JonathanDGonzalez/Wind-Turbine-Emulator-Gateway/docs/final_paper.pdf

Emulacion experimental y supervisi ´ | on SCADA de ´

# un subsistema eolico de 300 W para microrredes DC ´ basado en PMSG

Jonathan David Gonzalez Cubides ´
Departamento de Ingeniería Electrica y Electr ´ | onica ´
Universidad de los Andes
Bogota, Colombia ´
jd.gonzalezc1@uniandes.edu.co 202210906

Juan David Roa Ballen´
Departamento de Ingeniería Electrica y Electr ´ | onica ´
Universidad de los Andes
Bogota, Colombia ´
jd.roab1@uniandes.edu.co
202212846

Cristian David Gonzalez Mayorga ´
Departamento de Ingeniería Electrica y Electr ´ | onica ´
Universidad de los Andes
Bogota, Colombia ´
cd.gonzalezm1@uniandes.edu.co 202210911
Resumen—Este documento presenta el diseno, implementaci ˜ | on´
y validacion experimental de un subsistema e ´ | olico de baja ´
potencia (300 W) orientado a su integracion en una microrred ´ DC de laboratorio de 48 V. El subsistema propuesto consta de un generador síncrono de imanes permanentes (PMSG)
acoplado mecanicamente a un motor de inducci ´ | on operado por ´
un variador de frecuencia comercial. El control del variador se realiza mediante una pasarela de comunicacion basada en un ´
sistema embebido que actua de forma simult ´ | anea como maestro ´
Modbus RTU y servidor Modbus TCP, permitiendo la emulacion´ automatizada de perfiles reales de velocidad de viento sintetizados
a partir de datos meteorologicos y la supervisi ´ | on en tiempo real ´
desde un sistema SCADA externo. La validacion experimental ´
confirmo con precisi ´ | on las relaciones f ´ | ísicas fundamentales de
la maquina, demostrando un comportamiento lineal tensi ´ | on- ´
frecuencia (V ∝ ω) y cuadratico potencia-frecuencia ( ´ | P ∝ ω

2
),
con margenes de error inferiores al 5 % en todo el rango de ´ operacion. Con esto, se valida la robustez y viabilidad de la ´ plataforma como herramienta de prueba para estrategias de
control y gestion en microgeneraci ´ | on distribuida. ´
Palabras clave—control de microgeneracion, emulaci ´ | on e ´ | olica, ´
microrredes DC, PMSG, Protocolos de comunicacion industrial, ´ sistemas embebidos de bajo costo.
I. INTRODUCCION´

El creciente interes en las microrredes de corriente continua ´
(DC) como arquitectura eficiente para la integracion de energ ´ | ías
renovables, sistemas de almacenamiento y cargas electronicas ´ ha motivado el desarrollo de prototipos de laboratorio que
permitan estudiar fenomenos de estabilidad, control y gesti ´ | on´
energetica [1]. Dentro de las fuentes renovables, la generaci ´ | on´
eolica presenta desaf ´ | íos particulares debido a la variabilidad
temporal del recurso y a su naturaleza de corriente alterna (AC), que exige etapas de rectificacion, acondicionamiento y ´ control para su acoplamiento a un bus DC comun. ´
En sistemas de baja potencia (300 W–1 kW), los generadores síncronos de imanes permanentes (PMSG) se han posicionado como una opcion atractiva por su alta eficiencia, mantenimiento ´ reducido y facilidad de control [2], [3]. Sin embargo, gran parte de los estudios reportados en la literatura se basan en simulaciones computacionales o emplean plataformas de control cerradas y costosas, limitando la reproducibilidad y el
acceso en entornos academicos de desarrollo local. Adem ´ | as, ´

existe una brecha en la integracion de sistemas de sensado ´ accesibles con estrategias de emulacion de perfiles de viento ´ realistas bajo entornos de supervision industrial estandarizados. ´ Factor diferenciador de este trabajo: integracion completa ´ de una metodología de emulacion reproducible fundamentada ´
en perfiles sinteticos din ´ | amicos obtenidos a partir del ´ | Global
Wind Atlas. El control del sistema se implementa mediante un entorno accesible compuesto por una Raspberry Pi 4 que opera sobre un variador comercial Allen-Bradley PowerFlex
525 vía Modbus RTU, acoplandose directamente a la validaci ´ | on´
experimental del generador PMSG AVAN-300W mediante software de codigo abierto en Python. A diferencia de las ´ aproximaciones convencionales que dependen de simulacion´ computacional pura o de costosas plataformas dSPACE que restringen su escalabilidad, este esquema proporciona un banco de ensayos flexible y de bajo costo. La plataforma permite caracterizar parametricamente el PMSG mediante curvas de ´
tension-corriente ( ´ | V -I) y eficiencia, validar algoritmos de
seguimiento del punto de maxima potencia (MPPT), evaluar ´ el comportamiento de convertidores AC-DC bajo perfiles transitorios y dimensionar microrredes DC experimentales para aplicaciones aisladas.
Por lo tanto, la principal contribucion de este trabajo radica ´ en el desarrollo de una plataforma de emulacion e ´ olica que no ´ solo reproduce perfiles dinamicos reales basados en bases de ´
datos meteorologicas globales, sino que integra la telemetr ´ | ía
local de una PCB propia con la supervision jer ´ | arquica industrial. ´
Esto permite estudiar el impacto de la microgeneracion y los ´ armonicos de corriente en microrredes DC bajo condiciones ´ controladas y repetibles de laboratorio.
El resto de este documento esta organizado de la siguiente ´
manera: la Seccion II describe los fundamentos te ´ | oricos, la ´
síntesis de perfiles de viento y el marco regulatorio. La Seccion´
III detalla el sistema de instrumentacion y supervisi ´ | on SCADA. ´
La Seccion IV presenta el an ´ | alisis comparativo de m ´ | aquinas ´
electricas. La Secci ´ | on V expone los paradigmas de control ´
MPPT y la proyeccion de desarrollo tecnol ´ | ogico. La Secci ´ | on´
VI analiza los resultados de la validacion experimental y la ´
caracterizacion electromec ´ | anica. La Secci ´ | on VII aborda la es- ´
trategia de conversion frecuencial y s ´ | íntesis del perfil dinamico ´

de viento. La Seccion VIII profundiza en la arquitectura de ´ comunicacion concurrente y la pasarela dual Modbus, y la ´
Seccion IX resume las conclusiones de la investigaci ´ | on. ´
II. FUNDAMENTOS TEORICOS ´ | , SÍNTESIS DE VIENTO Y

CONTEXTO NORMATIVO

La emulacion precisa de una turbina e ´ | olica en un entorno ´
de laboratorio requiere la integracion de bases de datos ´
meteorologicas de alta resoluci ´ | on, el modelamiento de la ´
extraccion de potencia mec ´ | anica del rotor y el an ´ | alisis de ´
la etapa de conversion est ´ | atica bajo el marco regulatorio ´
internacional.

II-A. Fuentes de Datos y Seleccion del Recurso ´
La caracterizacion matem ´ | atica del recurso e ´ | olico depende ´
de matrices validadas. Arquitecturas globales como NASA POWER [4] y el NREL WIND Toolkit [5] proporcionan series temporales extensas mediante modelos de mesoescala WRF. No obstante, para el desarrollo de plataformas de emulacion a ´ microescala, el Global Wind Atlas (GWA) desarrollado por la
DTU [6] constituye el estandar ´ | optimo debido a su resoluci ´ | on´
espacial de 250 m y al modelamiento microtopografico del ´ flujo. Para este estudio, se seleccionaron los datos climaticos ´ de la region de La Guajira, Colombia. A partir del GWA se ´ extrajeron dos conjuntos de datos: la matriz de distribucion´ horaria y mensual de velocidad media (heatmapData.csv) y la densidad de probabilidad de percentiles de velocidad (windSpeed.csv), permitiendo sintetizar perfiles dinamicos ´ representativos que superan las aproximaciones convencionales.

II-B. Modelamiento Aerodinamico de la Turbina ´
Un emulador eolico reproduce la respuesta din ´ | amica de un ´
rotor real acoplando mecanicamente un motor de accionamiento ´ controlado a un generador electrico [7], [8]. Para una turbina ´
eolica de eje horizontal (HAWT), el par aerodin ´ | amico ( ´ | Tturb)
transferido al eje se deriva de la potencia cinetica extra ´ | ída del
flujo de viento:

Tturb =

1
2

ρACp(λ, β)

v

3
w
ω

(1)

donde ρ representa la densidad local del aire, A es el area de ´
la seccion transversal barrida por las palas, ´ | | vw es la velocidad
instantanea del viento y ´ | ω es la velocidad angular mecanica del ´
rotor. El coeficiente de potencia Cp es una funcion no lineal ´
adimensional que depende del angulo de paso de la pala ( ´ | | β)
y de la relacion de velocidad perif ´ | erica ( ´ | λ = ωR/vw), donde
R corresponde al radio exterior del rotor. En configuraciones de eje vertical (VAWT) tipo Savonius, el par aerodinamico se ´ modela mediante el coeficiente de par efectivo (CT ), reduciendo
la sensibilidad cubica de la velocidad del viento a una relaci ´ | | on´
cuadratica dada por: ´

Tturb,VAWT =

1
2

ρAlatRefCT (λ)v

2
w | (2)
donde Alat es el area lateral proyectada y ´ | Ref es el radio
geometrico efectivo del dispositivo. Las variaciones din ´ | amicas ´

de vw se traducen en consignas de frecuencia electrica aplicadas ´ al estator del motor de induccion para simular la inercia ´ mecanica y las curvas de par reales. ´

II-C. Síntesis Estocastica de Perfiles de Viento para Ensayo ´ Para evaluar la robustez de la microrred DC ante transitorios, un algoritmo de síntesis estocastica en Python genera perfiles de ´ viento de tres días con resolucion de ´ ∆t = 1.0 s, combinando componentes determinado-estacionales y fluctuaciones de alta frecuencia:

vw(t) = α · vbase(h, m) + r · vturb(t) | (3)

donde vbase es la velocidad media diurna y mensual del
GWA segun la hora ( ´ | h) y el mes (m), ponderado por un
coeficiente espectral α = 0.7. La turbulencia se introduce
mediante el termino ´ | vturb(t), generado a traves de un muestreo ´
aleatorio sobre la probabilidad empírica de la region ( ´ | r = 0.3).
Para eliminar discontinuidades no físicas y emular la inercia atmosferica real, la serie temporal se somete a un filtro de ´ media movil s ´ íncrono:

vfinal(t) = 1
N

N/
X

2

i=−N/2

vw(t + i∆t) | (4)

con una ventana de suavizado de N = 10 muestras. Este perfil se convierte a consignas limitadas por las velocidades de corte (cut-in de 3.0 m/s, cut-out de 25.0 m/s) y nominal
(11.0 m/s), exportandose a ´ | | perfil_viento.csv como la
entrada dinamica para la pasarela de control. ´
II-D. Topologías de Rectificacion e Integraci ´ | on Normativa ´
La conversion de la energ ´ | ía AC generada por el PMSG hacia
el bus DC se efectua primariamente mediante un puente de ´ diodos trifasico no controlado de seis pulsos (puente de Graetz). ´ Esta topología destaca por su alta confiabilidad, ausencia de
perdidas por conmutaci ´ | on activa y costo m ´ | ínimo [9]. El voltaje
DC promedio obtenido en bornes bajo condiciones de vacío responde a VDC,avg = (3√
| | 2/π)Vrms,linea. A pesar de sus
ventajas estructurales, esta configuracion pasiva exhibe un ´ rizado del 16 % y carece de regulacion activa, provocando ´
caídas de tension severas gobernadas por la reactancia s ´ | | íncrona
interna del PMSG ante la conexion de cargas. Como alternativa ´ avanzada para independizar el voltaje del bus de la carga y controlar el factor de potencia, se consideran las arquitecturas controladas por modulacion de ancho de pulso (PWM) basadas ´ en IGBTs. Convertidores tipo elevador, como el rectificador
SEPIC trifasico operado en modo de conducci ´ | | on discontinua ´
(DCM), aprovechan las inductancias internas del estator como filtros de entrada, reduciendo la distorsion arm ´ onica al forzar ´ corrientes senoidales en fase con los voltajes inducidos y proveyendo una regulacion del bus con errores inferiores al ´ 3 % sin requerir lazos de comunicacion externa [10], [11]. ´ Esta integracion est ´ a sujeta a normativas internacionales ´ orientadas a preservar la calidad de la energía. El estandar ´ IEC 61400-21 restringe el parpadeo lumínico (flicker de corto plazo, Pst) a un valor maximo de 0.3 para 10 eventos en un ´

intervalo de 2 horas, limitando la distorsion arm ´ onica total ´ (THD) por debajo del 5 %, y exigiendo un desequilibrio de
tension inferior al 2 % en per ´ | íodos de 10 minutos [12]. Por
su parte, la norma IEEE 1547-2018 regula la interconexion de ´ recursos distribuidos, imponiendo rangos operativos de tension´ entre el 88 % y el 110 % del valor nominal, tolerancias de frecuencia de 59.3 Hz a 60.5 Hz, y capacidad de soporte ante fallas (Fault Ride-Through, FRT) [13]. Debido a que el subsistema desarrollado opera en una microrred de laboratorio en modo aislado (islanding), los requerimientos de soporte ante fallas masivas (FRT) y los lazos de sincronizacion de ´ fase (PLL) pasan a un plano secundario. Los esfuerzos se reorientan hacia la gestion local del balance de potencia activa, ´ la mitigacion de sobretensiones transitorias en el bus de 48 V ´ mediante la pasarela embebida, y la instrumentacion de alta ´ fidelidad para caracterizar la respuesta electromecanica del ´ banco de ensayos.

III. SISTEMA DE INSTRUMENTACION´ , ADQUISICION Y ´ SUPERVISION´ SCADA

La caracterizacion din ´ | amica del subsistema e ´ | olico y la ´
evaluacion de su impacto en la estabilidad de la microrred ´ DC requieren una arquitectura de instrumentacion de alta ´
fidelidad, capaz de registrar variables electricas y t ´ | ermicas ´
de forma simultanea sin introducir retardos en los lazos de ´ control locales.
III-A. Instrumentacion Electr ´ | onica y Adquisici ´ | on en la Fron- ´
tera (Edge)
Para la digitalizacion y procesamiento de las se ´ | nales anal ˜ | ogi- ´
cas en el nodo primario de control, se desarrollo un sistema ´ de adquisicion basado en el microcontrolador de arquitectura ´ abierta ESP32-S2 WROVER. Este dispositivo gestiona el acondicionamiento de senales provenientes de transductores ˜ específicos seleccionados por su linealidad y rango dinamico, ´ los cuales se consolidan en la Tabla I.

Tabla I: Sensores Integrados en la Plataforma Experimental

Variable Mapeada | Transductor Integrado | Interfaz de Datos
Corriente AC/DC | ACS758LCB-050B (Efecto Hall) | Analogica (ADC) ´
Tension y Potencia DC | M ´ | odulo INA226 (Monitoreo Bus) | Digital (I ´

2C)
Temperatura de Maquina Termocupla Tipo K + MAX6675 | Digital (SPI) ´
Procesamiento de Borde | ESP32-S2 WROVER Core | MCU 32-bits

La topología de hardware aprovecha el convertidor analogico- ´ digital (ADC) nativo de 12 bits del microcontrolador para el seguimiento de la corriente inyectada por el rectificador, implementando filtros digitales de media movil para mitigar ´ el ruido de alta frecuencia inducido por las conmutaciones. Asimismo, la integracion del monitor de potencia INA226 ´ mediante el bus I

2C permite independizar la lectura de la
tension del bus de 48 V con una resoluci ´ | | on centesimal superior, ´
asegurando un error de cuantificacion despreciable en el c ´ | alculo ´
del balance energetico neto. ´

III-B. Arquitectura IoT de Supervision y Monitoreo Remoto ´

Para lograr un flujo de informacion bidireccional continuo ´ hacia el entorno de supervision jer ´ arquica sin degradar los ´ tiempos de ciclo del maestro Modbus RTU, se implementó una arquitectura distribuida orientada al Internet de las Cosas Industrial (IIoT), estructurada de acuerdo con la topología jerarquica de la Figura 1. ´

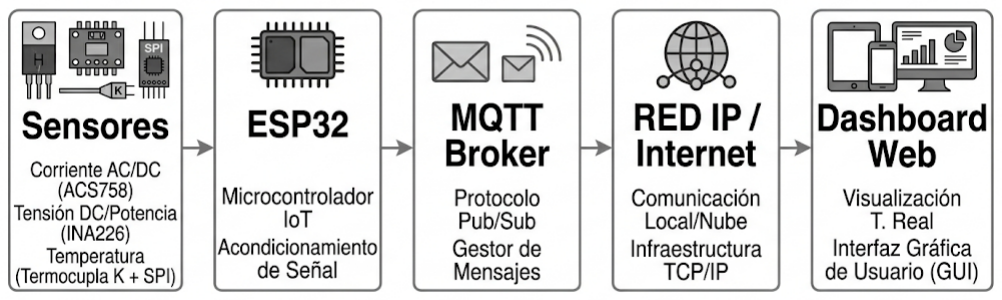
[picture p1: figure]

Figura 1: Arquitectura IoT de supervision distribuida y capas ´ de telemetría.

El esquema operativo se divide en tres capas funcionales continuas: la Capa de Borde (Edge Computing), donde el firmware del ESP32 realiza el muestreo determinista de las variables físicas y empaqueta las lecturas en una estructura de datos serializada; la Capa de Transporte Asíncrono, encar-gada de la transmision inal ´ ambrica hacia un servidor central ´ (Broker) bajo el protocolo MQTT, seleccionado por su modelo
Publicacion/Suscripci ´ | on (Pub/Sub) y m ´ | ínima sobrecarga de red
(overhead) frente a esquemas HTTP; y la Capa de Aplicacion y ´
Visualizacion´ , donde los topicos de telemetr ´ | ía son consumidos
en tiempo real por un Dashboard supervisor para ejecutar
tareas de registro historico ( ´ | datalogging) indispensable en la
validacion emp ´ | írica de las curvas de eficiencia.
IV. ANALISIS ´ | COMPARATIVO DE MAQUINAS ´ | ELECTRICAS ´
PARA MICRO-EOLICA ´
La seleccion del generador el ´ | | | ectrico representa el criterio de ´
diseno cr ˜ | ítico en sistemas eolicos a peque ´ | na escala (300 W a ˜
1 kW), puesto que determina la configuracion de las etapas de ´ potencia y los límites operativos del control de velocidad. En este rango, coexisten tres topologías principales: las maquinas ´
de induccion, las m ´ | aquinas s ´ | íncronas excitadas por campo y
los generadores síncronos de imanes permanentes (PMSG) [2], [3].
Tabla II: Matriz de Seleccion Tecnol ´ | ogica de Generadores ´
Eolicos ´
Metrica de Evaluaci ´ | on | Inducci ´ | on | S ´ | íncrono Exc. | PMSG
Naturaleza de la Salida | AC Variable | AC Variable | AC Variable
Mecanismo de Excitacion Externa (Red) Corriente Campo Imanes Internos ´
Rango Operativo de ω | Reducido | Moderado | Amplio
Eficiencia Energetica | Media | Media-Alta | Sobresaliente ´
Complejidad de Control | Moderada | Elevada | Reducida
Frecuencia Mantenimiento | Mínima | Moderada-Alta | Mínima
Acoplamiento a Bus DC | Moderado | Complejo | Optimo ´
Costo Estructural Relativo | Bajo | Medio | Medio-Alto

Como se tabula en la matriz de seleccion de la Tabla II, las ´
maquinas de inducci ´ | on exhiben restricciones severas debido a ´
su necesidad de una fuente externa de potencia reactiva para establecer el flujo magnetico, limitando su operabilidad en ´ microrredes aisladas. Por otro lado, los generadores síncronos excitados por bobinados de campo introducen perdidas ´ ohmicas ´ adicionales en el rotor y requieren anillos rozantes que elevan los índices de mantenimiento.
Por consiguiente, para el desarrollo de este emulador se selecciono un generador tipo PMSG (AVAN-300W). Esta ´
maquina elimina por completo los lazos de excitaci ´ | | on activa ´
mediante la incorporacion de imanes permanentes de alta ´ densidad energetica, maximizando la eficiencia global de ´ conversion y garantizando un acoplamiento directo y altamente ´ lineal con el bus de rectificacion pasiva DC bajo un rango ´
extendido de velocidades mecanicas de rotaci ´ | on. ´
V. ESTRATEGIAS DE CONTROL MPPT Y PROYECCION DE ´
| DESARROLLO FUTURO
La integracion eficiente del subsistema e ´ | olico basado en ´
PMSG dentro de una microrred DC requiere de algoritmos de
seguimiento del punto de maxima potencia ( ´ | Maximum Power
Point Tracking, MPPT) adaptados a la dinamica transitoria ´
del recurso eolico sint ´ | etico. El objetivo fundamental de estas ´
estrategias consiste en manipular la velocidad angular del rotor (ω) para mantener el sistema operando de manera continua en
la razon de velocidad de punta ´ | optima ( ´ | λopt), maximizando
así el coeficiente de rendimiento aerodinamico ( ´ | Cp).

V-A. Paradigmas de Control MPPT en Maquinas PMSG ´
En el diseno de emuladores y sistemas micro-e ˜ | olicos ´
reales, coexisten tres filosofías principales de optimizacion. ´
El control por relacion de velocidad de punta ( ´ | Tip Speed
Ratio, TSR) calcula en tiempo real la velocidad angular optima ´
mediante la medicion directa del viento utilizando la relaci ´ | | | on´
ωref = (λopt/R)vw. Aunque exhibe una respuesta transitoria
veloz, depende críticamente de un anemometro f ´ | ísico, el
cual introduce costos adicionales y errores por turbulencias
locales. Para prescindir de estos sensores mecanicos, el m ´ | etodo ´
de control de par optimo ( ´ | Optimal Torque Control, OTC)
explota la relacion cuadr ´ | atica intr ´ | ínseca de la turbina mediante
la ley Topt | = kω²
, donde k se calibra a partir de los
parametros geom ´ | etricos del rotor y la densidad del aire. ´
El metodo OTC destaca por su robustez frente a r ´ | afagas ´
de viento y su simplicidad computacional, permitiendo su codificacion directa en el ESP32 sin comprometer los tiempos ´ de ciclo. Finalmente, cuando las constantes constructivas son
desconocidas o varían por degradacion mec ´ | anica, se recurre a ´
la busqueda adaptativa por perturbaci ´ | on y observaci ´ | on ( ´ | Hill
Climbing Search, HCS). Este algoritmo, agnostico al modelo ´ físico, perturba cíclicamente la velocidad de referencia y evaluá el gradiente de potencia neta (∆P/∆ω) para converger al
optimo; no obstante, su velocidad de convergencia es m ´ | | | as´
lenta y exhibe oscilaciones en regimen permanente. La elevada ´ linealidad de la fuerza electromotriz (FEM) inducida respecto a la velocidad angular del PMSG seleccionado facilita la futura programacion de cualquiera de estas tres variantes analizadas ´ en el nodo de borde.

V-B. Trabajo Futuro: Convertidor MPPT y Estabilizacion del ´ Bus de 48 V
A partir de la infraestructura desarrollada, se definen dos líneas críticas de trabajo futuro orientadas a consolidar la autonomía de la microrred DC aislada utilizando hardware abierto: 1) Implementacion de una Etapa de Potencia ´ Activa (Boost MPPT): Se proyecta el diseno de un convertidor ˜
estatico DC-DC tipo elevador ( ´ | Boost) controlado mediante el
microcontrolador de borde. Esta etapa sustituira la transferencia ´ pasiva actual, ejecutando físicamente los algoritmos OTC o HCS para ajustar dinamicamente la impedancia vista por el ´
rectificador y forzar la operacion del PMSG en su m ´ | axima ´
eficiencia. 2) Integracion de Almacenamiento e Hibridaci ´ | on´
del Bus DC: Con el proposito de mitigar las fluctuaciones ´ de tension inducidas en el bus de 48 V por la naturaleza ´
estocastica del viento emulado, se integrar ´ | a un sistema h ´ | íbrido
de almacenamiento compuesto por baterías de ion-litio y
supercapacitores. Este sistema absorbera o inyectar ´ | a potencia ´
de forma bidireccional durante rafagas o ca ´ | ídas del recurso,
asegurando la estabilidad de tension ante variaciones operativas ´ de la demanda.
Estas expansiones tecnologicas permitir ´ | an complementar ´
el estudio con un analisis de viabilidad tecno-econ ´ | omica ´
estructurado bajo la metodología del costo nivelado de la energía (LCOE) para microrredes rurales aisladas, optimizando
el compromiso costo-desempeno mediante instrumentaci ˜ | on IoT ´
flexible y hardware comercial robusto.

VI. VALIDACION´ EXPERIMENTAL Y CARACTERIZACION´
ELECTROMECANICA DEL ´ | | SISTEMA
Con el proposito de validar los modelos matem ´ | aticos del ´
generador y evaluar la eficiencia de la conversion pasiva AC- ´
DC, se ejecuto una caracterizaci ´ | on est ´ | atica y din ´ | amica sobre ´
el banco de pruebas implementado en la Seccion´ ??.

VI-A. Metodología de Ensayo y Banco de Pruebas
El banco esta integrado por un motor de inducci ´ | on trif ´ | asico ´
(SE2672-3G2) acoplado rígidamente a un generador PMSG NdFeB (AVAN-300W). El motor es gobernado por el variador PowerFlex 525 (supervisado vía Connected Components Work-bench) y la salida AC del generador se conecta en paralelo al puente rectificador de diodos. Para evaluar el desempenõ bajo carga en el dominio DC, se utilizo un re ´ ostato calibrado ´ a valores fijos de 20 Ω, 53 Ω, 100.2 Ω, 150.4 Ω y 200 Ω,
contrastandolo con un ensayo previo en vac ´ | | | ío. El procedimiento
consistio en barrer la frecuencia del estator de 5 Hz a 60 Hz ´ en pasos discretos, registrando magnitudes RMS en AC y
promedio en DC tras la estabilizacion t ´ | ermica y mec ´ | anica del ´
sistema.

VI-B. Especificaciones de los Componentes Principales Las especificaciones tecnicas de los equipos del banco de ´ pruebas se resumen en la Tabla III.

Tabla III: Especificaciones Tecnicas del Equipamiento Principal ´

Componente Mapeado Modelo Comercial | Límites Operativos de Disenõ
Variador de Frecuencia | PowerFlex 525 | | 0.4 kW, 0–500 Hz, Modbus RTU
Motor de Induccion | SE2672-3G2 | 0.37 kW, 3360 rpm, 2 polos, 60 Hz ´
Generador Síncrono | AVAN-300W | | 300 W, PMSG, 600 rpm nominal
Rectificador de Potencia | Trifasico Diodos | Configuraci ´ | on Puente de Graetz ´
VI-C. Resultados en Regimen de Vac ´ | ío (Open-Circuit Valida-
tion)

VI-C1. Mediciones en el Dominio DC sin Carga: Los valores de tension promedio en DC se consolidan en la ´ Tabla IV y su tendencia lineal se ilustra en la Figura 2. La tension incrementa proporcionalmente con las RPM hasta ´ alcanzar 171.49 V a 60 Hz (≈ 3360 rpm), validando la relacion´ fundamental de la fuerza electromotriz inducida (V ∝ ω) propia del flujo constante del rotor en maquinas PMSG. ´

Tabla IV: Tension DC Promedio en Vac ´ | | | ío a la Salida del
Rectificador

Frecuencia [Hz] Voltaje DC [V] Frecuencia [Hz] Voltaje DC [V]

5 | 16.0 | 35 | 100.09
10 | 29.8 | 40 | 114.59
15 | 43.69 | 45 | 128.70
20 | 57.7 | 50 | 143.09
25 | 71.7 | 55 | 157.40
30 | 86.09 | 60 | 171.49

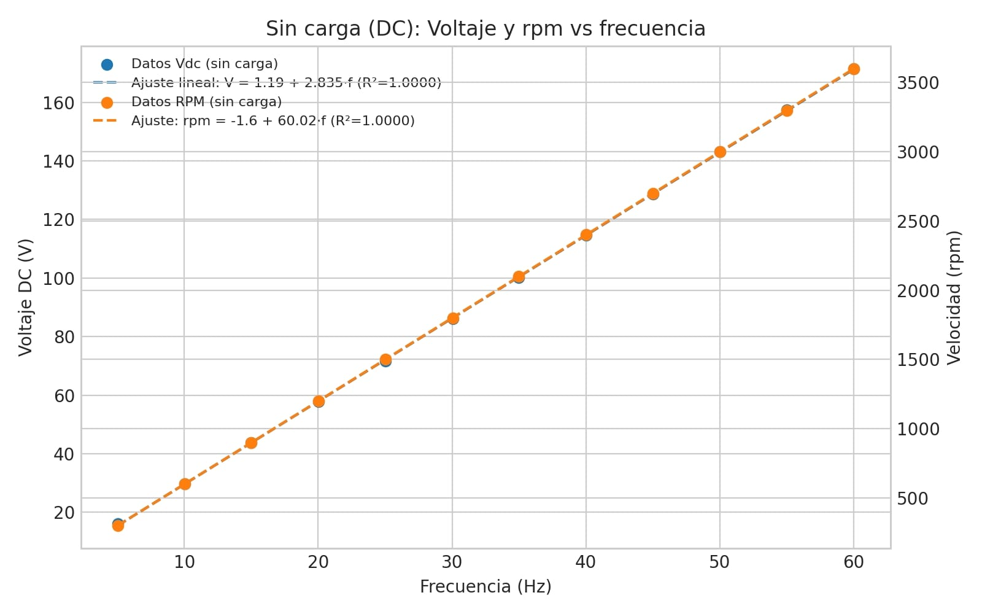
[picture p2: figure]

Figura 2: Característica lineal de la tension del bus DC en ´ vacío vs. frecuencia.

VI-C2. Mediciones en el Dominio AC sin Carga: Las tensiones de línea (Vlinea) y fase (Vfase) RMS en los bornes del PMSG se registran en la Tabla V y se ilustran en la Figura 3. Las curvas paralelas muestran una respuesta lineal con asimetrías menores al 3 % atribuidas a desbalances constructivos menores en los devanados del estator, verificando que la relacion entre ´ voltajes fase-fase y fase-neutro converge al factor √
3 del
sistema trifasico balanceado. ´

VI-D. Resultados Bajo Carga Resistiva en el Dominio DC La potencia disipada (Tabla VI y Figura 4) demuestra de
forma contundente una trayectoria parabolica que valida emp ´ | íri-
camente la relacion cuadr ´ | atica ´ | P ∝ ω

2
. A 60 Hz con 20 Ω,
el sistema transfirio una potencia neta de 294.1 W (pr ´ | oxima ´
a los 300 W nominales). El analisis de regulaci ´ | on revela que ´
Tabla V: Valores RMS de Tensiones AC Estatoricas en Vac ´ | ío

Frec. [Hz] VAB [V] VAC [V] VCB [V] VAN [V] VCN [V] VBN [V]

10 | 130 | 120 | 130 | 32 | 30 | 34
20 | 190 | 185 | 185 | 64 | 62 | 68
30 | 250 | 245 | 248 | 96 | 92 | 102
40 | 300 | 292 | 292 | 128 | 120 | 132
50 | 360 | 350 | 350 | 156 | 152 | 166
60 | 410 | 400 | 410 | 188 | 180 | 198

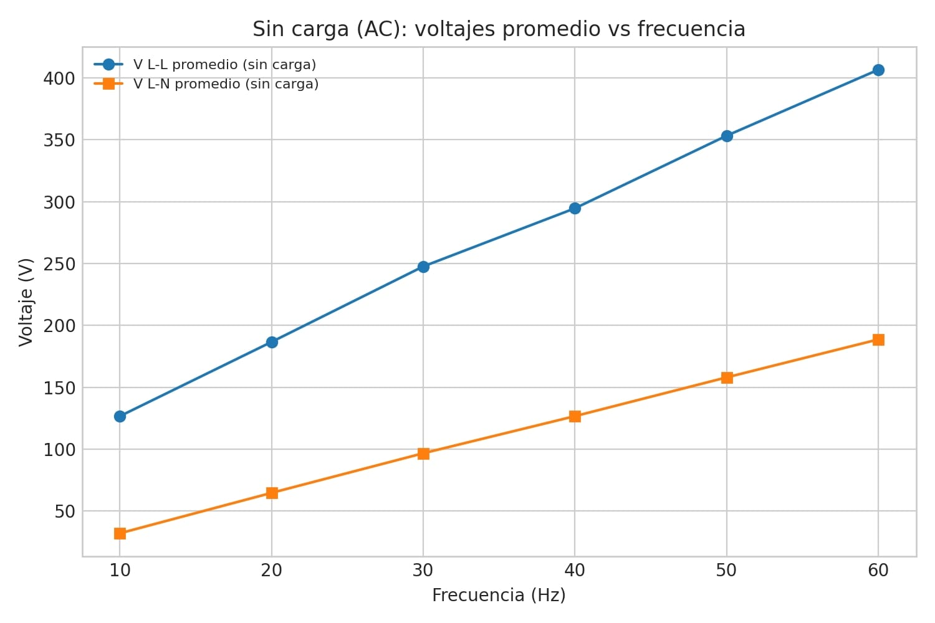
[picture p3: figure]

Figura 3: Evolucion de las tensiones RMS senoidales AC en ´ vacío.

bajo esta condicion la tensi ´ | on del bus DC experiment ´ | o una ´
caída severa del 55.27 % (de 171.49 V a 76.7 V), lo cual es una propiedad definitoria de esquemas de conversion pasivos ´ no regulados. Físicamente, esta perdida es inducida por la ´ reactancia síncrona interna, la resistencia estatorica ´ ohmica ´ ante altas corrientes y el solapamiento de conmutacion en ´ los diodos, ratificando la necesidad estricta de incorporar el convertidor Boost activo proyectado en la Seccion V. ´

Tabla VI: Resumen de Tension y Potencia DC Inyectada Bajo ´ Carga

Carga R [Ω] V30 [V] P30 [W] V60 [V] P60 [W]

20 | 47.7 | 113.8 | 76.7 | 294.1
53 | 65.9 | 81.9 | 124.8 | 293.9
100.2 | 71.5 | 51.0 | 138.0 | 190.1
150.4 | 74.0 | 36.4 | 144.8 | 139.4
200 | 75.6 | 28.6 | 144.8 | 104.8

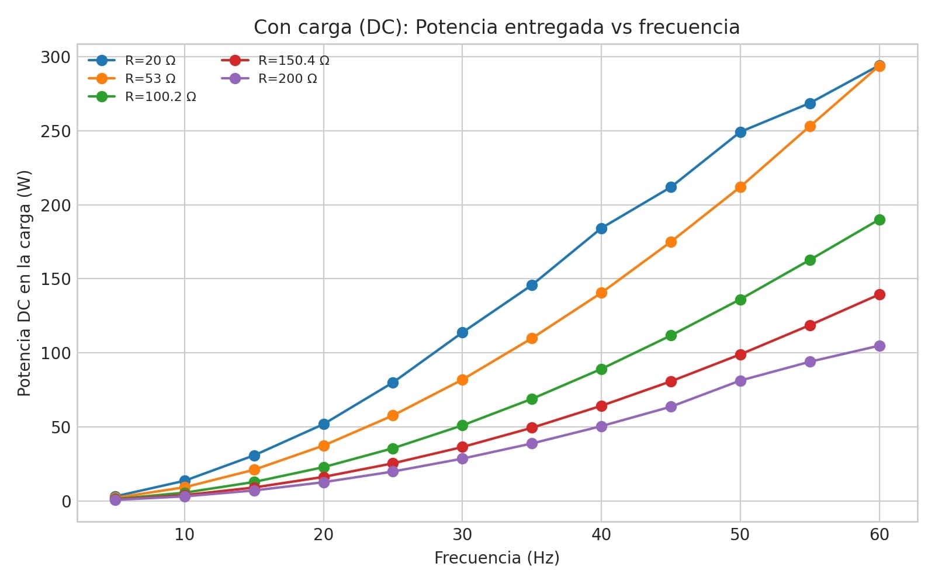
[picture p4: figure]

Figura 4: Potencia DC inyectada en funcion de la frecuencia ´ mecanica. ´

VI-E. Resultados Bajo Carga Resistiva en el Dominio AC Las Tablas VII y VIII detallan el comportamiento balanceado
trifasico de la m ´ | aquina bajo demanda energ ´ | etica, cuya evolu- ´
cion de tensiones de l ´ | ínea eficaces se compara espacialmente
en la Figura 5.

Tabla VII: Respuesta de Línea AC para una Carga de 50.4 Ω

Frec. [Hz] VAB [V] IAB [A] VAC [V] IAC [A] VCB [V] ICB [A]

10 | 54.4 | 1.079 | 46.0 | 0.913 | 50.0 | 0.992
20 | 107.0 | 2.123 | 92.0 | 1.825 | 96.0 | 1.905
30 | 148.0 | 2.937 | 130.0 | 2.579 | 136.0 | 2.698
40 | 196.0 | 3.889 | 178.0 | 3.532 | 176.0 | 3.492
50 | 234.0 | 4.643 | 210.0 | 4.167 | 216.0 | 4.286
60 | 280.0 | 5.556 | 250.0 | 4.960 | 250.0 | 4.960

Tabla VIII: Respuesta de Línea AC para una Carga de 200 Ω

Frec. [Hz] VAB [V] IAB [A] VAC [V] IAC [A] VCB [V] ICB [A]

10 | 64.0 | 1.270 | 60.0 | 1.190 | 62.0 | 1.230
20 | 122.0 | 2.421 | 118.0 | 2.341 | 120.0 | 2.381
30 | 178.0 | 3.532 | 172.0 | 3.413 | 178.0 | 3.532
40 | 236.0 | 4.683 | 234.0 | 4.643 | 236.0 | 4.683
50 | 300.0 | 5.952 | 294.0 | 5.833 | 296.0 | 5.873
60 | 366.0 | 7.262 | 360.0 | 7.143 | 356.0 | 7.063

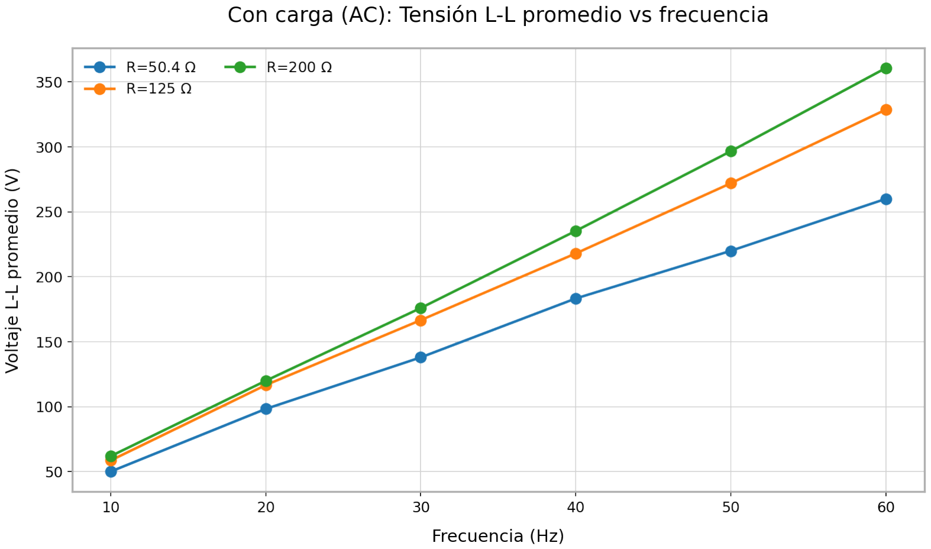
[picture p5: figure]

Figura 5: Voltajes RMS fase-fase bajo el efecto de carga resistiva AC.

VI-F. Validacion Cruzada y An ´ | alisis de Repetibilidad Externa ´
Con el fin de garantizar el rigor metodologico y certificar ´ la validez de la instrumentacion desarrollada, los resultados ´ obtenidos fueron contrastados de manera analítica con los datos de control reportados por Espitia en [14] bajo un protocolo
homologo de variaci ´ | on de velocidad angular. La Tabla IX ´
detalla las lecturas para una impedancia de referencia de 10 Ω, optimizando el espacio mediante muestreo síncrono, mientras que la Tabla X condensa la potencia activa bajo tres niveles de baja impedancia.
A pesar de que el rango de resistencias del estudio de control [14] opera en un espectro de menor magnitud, ambas plataformas confirman una coincidencia estructural absoluta
con trayectorias cuadraticas indexadas a la velocidad mec ´ | anica. ´
La varianza cuantitativa calcula desviaciones estandar inferiores ´ al 5 % en puntos homologos, validando la reproducibilidad del ´
metodo de conversi ´ | on y las conclusiones de estabilidad para el ´
subsistema de microgeneracion. Para garantizar los est ´ | andares ´

editoriales del IEEE, las ilustraciones y curvas experimentales fueron procesadas expandiendo la proporcion de sus etiquetas ´ de ejes y leyendas para asegurar legibilidad a doble columna.

Tabla IX: Matriz de Medicion Independiente (Espitia) – ´ | 10 Ω
RPM | Torque [Nm] | V [V] | I [A] | Potencia V I [W]
0 | 0.00 | 0.00 | 0.00 | 0.00
100 | 0.16 | 1.90 | 0.18 | 0.34
200 | 0.31 | 4.61 | 0.44 | 2.03
300 | 0.45 | 7.25 | 0.70 | 5.08
400 | 0.58 | 9.88 | 0.96 | 9.48
500 | 0.70 | 12.45 | 1.20 | 14.94
600 | 0.79 | 14.96 | 1.45 | 21.69

Tabla X: Potencia Activa Registrada por Espitia

RPM | Carga 10 Ω [W] | Carga 7.5 Ω [W] | Carga 5 Ω [W]
0 | 0.00 | 0.00 | 0.00
100 | 0.34 | 0.34 | 0.35
200 | 2.03 | 2.08 | 2.07
300 | 5.08 | 5.17 | 5.21
400 | 9.48 | 9.51 | 9.37
500 | 14.94 | 15.02 | 14.88
600 | 21.69 | 21.94 | 21.53

A pesar de que el rango de resistencias de Espitia opera en un espectro de menor magnitud, ambas plataformas confirman una coincidencia estructural absoluta con trayectorias cuadraticas ´ indexadas a la velocidad mecanica. La varianza cuantitativa ´ calcula desviaciones estandar inferiores al 5 % en puntos ´
homologos, validando la reproducibilidad del m ´ | etodo de ´
conversion y las conclusiones de estabilidad para el subsistema ´
de microgeneracion. Para garantizar los est ´ | andares editoriales ´
del IEEE, las ilustraciones y curvas experimentales fueron procesadas expandiendo la proporcion de sus etiquetas de ejes ´ y leyendas para asegurar legibilidad a doble columna.

VII. ESTRATEGIA DE CONVERSION´ FRECUENCIAL Y
SÍNTESIS DEL PERFIL DINAMICO DE ´ | VIENTO

Para reproducir fielmente en el laboratorio el comportamiento de una turbina eolica real a partir de series temporales ´
meteorologicas, se dise ´ | nõ e implement ´ | o un algoritmo de ´
acoplamiento cinematico. Este modelo traduce las variaciones ´ de la velocidad instantanea del viento en consignas operativas ´
de frecuencia electrica ( ´ | Hz) dirigidas al variador Allen-Bradley
PowerFlex 525. A diferencia de las aproximaciones complejas
basadas en la medicion continua de la raz ´ | on de velocidad de ´
punta (TSR), que imponen una alta carga computacional y
dependen estrictamente de parametros geom ´ | etricos espec ´ | íficos
de las palas, este trabajo desarrolla una metodología practica, ´ robusta y scalables fundamentada en la discretizacion por ´ tramos de la curva de potencia característica de una aeroturbina de pequena escala. ˜

VII-A. Modelamiento Matematico de la Curva por Tramos ´ La respuesta cinematica de la turbina simulada se segmenta ´ de forma determinista en tres regiones operativas críticas gobernadas por velocidades de viento de referencia. La primera es la velocidad de arranque o conexion ( ´ cut-in, vcut-in), umbral

mínimo donde el recurso eolico posee la energ ´ | ía cinetica nece- ´
saria para vencer la inercia rotacional y la friccion del estator ´ (f = 0 Hz). La segunda es la velocidad nominal (vnom), punto
de diseno donde el generador alcanza su m ˜ | axima transferencia ´
de potencia activa y a partir del cual la pasarela de control satura la consigna frecuencial en un límite superior (fmax´ ) para prevenir sobrecargas termicas en los devanados. Finalmente, la ´ velocidad de parada o desconexion ( ´ cut-out, vcut-out) define el límite de seguridad estructural ante rafagas severas, forzando ´
la detencion inmediata del emulador ( ´ | f = 0 Hz).
La transicion din ´ | amica comprendida entre la velocidad de ´
conexion y la nominal define la zona de generaci ´ | on variable, ´
donde la frecuencia de referencia experimenta una variacion´ lineal proporcional a la velocidad del viento, implementada rigurosamente mediante la funcion por tramos expresada en ´ (5):

fref(vw) =

0 | vw < vcut-in ó vw > vcut-out

fmax´ ·

vw − vcut-in

vnom − vcut-in

| vcut-in ≤ vw ≤ vnom
fmax´ | vnom < vw ≤ vcut-out

(5)

VII-B. Parametros de Dise ´ | no y Restricciones Operativas ˜

Los límites operativos parametrizados en el script core del sistema se fijaron en: vcut-in = 3.0 m/s, vnom = 11.0 m/s, vcut-out = 25.0 m/s y fmax´ = 25.5 Hz. Limitar la operacion a ´ un techo de 25.5 Hz asegura que el motor-generador funcione de manera segura por debajo de su velocidad nominal de aislamiento (60 Hz), restringiendo los esfuerzos centrífugos en el acoplamiento rígido y garantizando que las variaciones de fuerza electromotriz inducida en el estator del PMSG generen magnitudes que no excedan la capacidad de disipacion de ´ 300 W del banco reostatico. A partir de estas constantes, la ´ pendiente operativa (m) dentro de la zona lineal se calcula mediante (6):

m =

fmax´

vnom − vcut-in

=

25.5
11.0 − 3.0

= 3.1875 Hz/(m/s) (6)

Consiguientemente, la ley de control lineal simplificada que gobierna el rango de microgeneracion activa queda unificada ´ bajo la expresion de (7): ´

| fref = 3.1875 · (vw − 3.0) [Hz] | (7)

Esta ecuacion es mapeada vectorialmente en tiempo real por ´ la funcion´ viento_a_frecuencia. Al evaluar el caso de estudio de La Guajira, donde el Global Wind Atlas reporta una velocidad media anual de 8.0 m/s a una altura de 100 m, la ley de control computa una consigna en estado estacionario de fref = 15.94 Hz, proporcionando un margen de seguridad
optimo que permite ante r ´ | afagas severas de hasta ´ | 25 m/s
la saturacion suave en 25.5 Hz sin activar protecciones por ´ sobrecorriente.

VII-C. Síntesis Algorítmica y Flujo de Datos del Perfil Estocastico ´

Para emular el comportamiento transitorio real, el algoritmo construye una serie temporal híbrida combinando asíncrona-mente dos matrices de datos del GWA. La primera define la tendencia base diurna y estacional a partir de la matriz de factores normalizados del archivo heatmapData.csv, indexada segun la hora y el mes. La segunda introduce la ´
dinamica de r ´ | afagas de alta frecuencia mediante un muestreo ´
aleatorio estructurado sobre la densidad empírica de percentiles
del archivo windSpeed.csv.
El procesamiento digital se ejecuta con una resolucion de ´ ∆t = 1.0 s para una ventana de 3 días. En cada iteracion se ´
realiza una interpolacion bilineal sobre el mapa t ´ | ermico para ´
derivar el factor espectral instantaneo, multiplic ´ | andolo por la ´
velocidad media anual por defecto (10 m/s) para establecer la velocidad base. Posteriormente, se inyecta la componente de turbulencia combinando los entornos (70 % tendencia, 30 % ruido de percentiles) y aplicando un filtro digital de media
movil de 10 segundos para eliminar discontinuidades no f ´ | ísicas
y emular la inercia atmosferica real. El perfil resultante se ´ convierte mediante (5) y se exporta a perfil_viento.csv, el cual es leído por la pasarela multi-hilo de la Raspberry Pi para transmitir secuencialmente las tramas vía Modbus RTU a una tasa estricta de 1 Hz, velocidad compatible con la respuesta dinamica del inversor que garantiza la estabilidad de ´ la microrred DC.

VIII. ARQUITECTURA DE COMUNICACION´ CONCURRENTE

Y PASARELA DUAL MODBUS

Para asegurar un control dinamico, determinista y reprodu- ´ cible del variador PowerFlex 525, se implemento un entorno ´
de comunicacion basado en Modbus RTU a trav ´ | es del puerto ´
serie RS-485 (DSI) del equipo, mitigando las restricciones de latencia no determinista y el overhead propios de protocolos basados en Ethernet industrial sobre plataformas de bajo costo.
VIII-A. Configuracion de la Red Serial e Interfaz F ´ | ísica de
Hardware

El variador PowerFlex 525 se parametrizo para operar bajo ´ un esquema de control remoto exclusivo por red, asignando los registros del puerto DSI como fuente unica para comandos ´ de marcha/parada y referencia de frecuencia, en estricto cumplimiento con las especificaciones del fabricante [15], consolidadas en la Figura 6.
La capa física se resolvio mediante el acoplamiento de un ´ convertidor industrial con aislamiento galvanico USB a RS- ´ 485 conectado a la Raspberry Pi 4. Las líneas de transmision´ diferencial balanceada (D+ y D–) se derivaron directamente a los pines 4 y 5 del conector RJ45 del variador, instrumentando el enlace con conductores de par trenzado apantallado (STP) conectados a la tierra comun para mitigar la interferencia ´ electromagnetica (EMI) de alta frecuencia inducida por el ´ inversor de potencia, de acuerdo al esquema de la Figura 7.

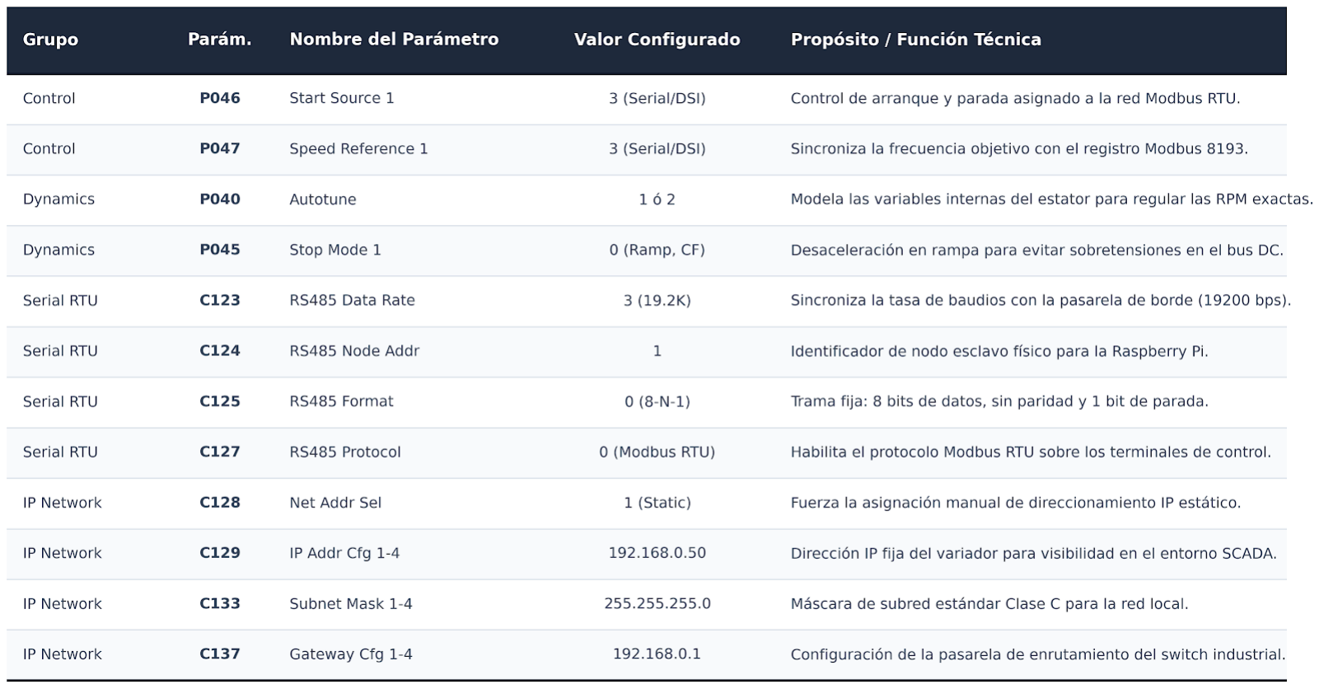
[picture p6: figure]

Figura 6: Parametros de Red y Comunicaci ´ | on del PowerFlex525 ´

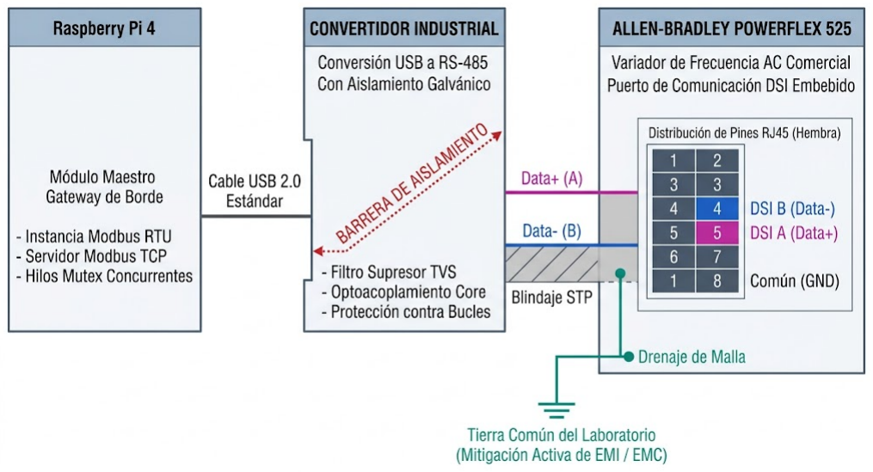
[picture p7: figure]

Figura 7: Esquema físico de interconexion serial RS-485 sobre ´ el bus de control DSI.

VIII-B. Logica de Operaci ´ | on Local y Dise ´ | no Multi-Hilo de ˜
la Pasarela

El entorno de software desarrollado en Python mediante la biblioteca pymodbus expone dos modos analíticos de
operacion local: un modo manual para la introducci ´ | | on de ´
frecuencias objetivo estaticas (0–60 Hz) con escalamiento ´ centesimal, y un modo perfil que ejecuta la lectura estructurada de perfil_viento.csv inyectando las referencias cada segundo. Para habilitar la supervision remota distribuida, ´ la arquitectura evoluciono hacia una pasarela bidireccional ´ concurrente de doble capa, donde el script core opera si-multaneamente como maestro en la red serial Modbus RTU ´ y como servidor de datos bajo el protocolo Modbus TCP/IP (puerto estandar 502) para el acoplamiento directo de sistemas ´ SCADA externos.
La mitigacion de colisiones representa el principal desaf ´ | | ío
de diseno en esta pasarela. Debido a que las peticiones ˜ SCADA y el lazo del perfil local actualizan los registros de frecuencia de forma asíncrona, el acceso al canal físico RS-
485 se encapsulo utilizando hilos de ejecuci ´ | | on independientes ´
(multithreading) protegidos estrictamente mediante primitivas
de exclusion mutua ( ´ | Mutex Locks). Este diseno garantiza que ˜
las peticiones TCP/IP sean encoladas y serializadas de manera
atomica, impidiendo la superposici ´ | on de bits en el bus f ´ | ísico
y la consecuente saturacion de los b ´ | uferes de recepci ´ | on del ´
inversor.
Asimismo, la pasarela resuelve activamente los requerimientos de robustez del variador. El PowerFlex 525 incorpora un temporizador de vigilancia (Watchdog) configurado a 5.0
segundos (parametro C126). Para satisfacer esta restricci ´ | on´
de hardware, el hilo serial ejecuta un lazo de entrada/salida continuo que inyecta cíclicamente (∆t = 300 ms) una trama unificada mediante la funcion´ write registers sobre las direc-
ciones contiguas 8192 (palabra de control logico) y ´ | 8193
(consigna de frecuencia). Esta tecnica opera como un ciclo de ´ heartbeat activo que restablece constantemente el temporizador. Si el enlace experimenta una desconexion, el variador detecta ´ de forma autonoma la ausencia de tramas tras superar los 5 ´ segundos, forzando una parada controlada en rampa (Ramp-to-Stop) para salvaguardar el bus DC de sobretensiones regenerativas destructivas. La pasarela estandariza la operacion´ traduciendo los comandos booleanos del SCADA hacia los registros de bajo nivel del hardware (decimal 18 para arranque en avance y decimal 1 para parada por inercia), estableciendo un entorno de borde robusto, estable y libre de colisiones.

IX. CONCLUSIONES

La caracterizacion y validaci ´ | on experimental del subsistema ´
eolico de 300 W permitieron corroborar con rigor las leyes ´
físicas que gobiernan a las maquinas s ´ | íncronas de imanes
permanentes bajo condiciones dinamicas. Los ensayos confir- ´ maron una proporcionalidad lineal para la fuerza electromotriz inducida respecto a la velocidad angular (V ∝ ω) y una trayectoria parabolica para la transferencia de potencia activa ´ (P ∝ ω

2
). La concordancia analítica con las mediciones independientes de Espitia, exhibiendo desviaciones inferiores al 5 %, certifica la alta repetibilidad del banco de pruebas. Desde la perspectiva del control automatico, estos hallazgos demuestran ´ que la frecuencia del estator escalada opera optimamente ´ como variable directa de realimentacion para algoritmos de ´
optimizacion MPPT, viabilizando la simplificaci ´ | | on estructural ´
del lazo cerrado al prescindir por completo de anemometros ´ mecanicos propensos a fallos. ´
Este trabajo demuestra la viabilidad tecnica y econ ´ | omica de ´
desarrollar plataformas avanzadas de emulacion y supervisi ´ | on´
industrial utilizando hardware de arquitectura abierta y bajo costo, rompiendo la dependencia hacia entornos propietarios restrictivos como dSPACE. La integracion concurrente multi- ´ hilo en la pasarela de la Raspberry Pi 4 garantizo un compor- ´ tamiento determinista en la coexistencia de las redes Modbus RTU y Modbus TCP/IP, mientras que los mecanismos de
proteccion basados en primitivas ´ | | Mutex y ciclos de heartbeat
activos mitigaron efectivamente el riesgo de colision de datos y ´ satisficieron el temporizador de vigilancia, previniendo estados de fallo por comunicacion ( ´ F081). De manera complementaria, el desacoplamiento de la capa de telemetría mediante el microcontrolador ESP32 y el protocolo MQTT demostro ser ´
una solucion robusta para aislar la supervisi ´ | | on remota en tiempo ´
real de los lazos de control críticos sobre el bus serie físico. No obstante la solidez del ecosistema de comunicaciones, el uso exclusivo de un banco de carga resistiva conectado a un rectificador pasivo evidencio las limitaciones del sistema en ´
terminos de regulaci ´ | on, registrando ca ´ | ídas de tension severas ´
del 55.27 % bajo condiciones de maxima demanda debido ´ a la reactancia síncrona interna del PMSG. Este fenomeno ´

justifica plenamente las líneas prioritarias para el desarrollo
futuro del proyecto, orientadas al diseno e instrumentaci ˜ | on de ´
un convertidor estatico DC-DC tipo ´ | Boost operado activamente
mediante leyes de control OTC o HCS para forzar la operacion´ en el punto de maxima eficiencia de la turbina. Finalmente, ´ se proyecta la hibridacion del bus de 48 V mediante la ´ incorporacion de un sistema de almacenamiento distribuido ´ basado en baterías de ion-litio y supercapacitores, proveerá el soporte dinamico bidireccional necesario para estabilizar ´ el voltaje de la microrred aislada ante el comportamiento
estocastico y variable del recurso e ´ | olico emulado. ´

REFERENCIAS

[1] T. Dragicevic, X. Lu, J. C. Vasquez, and J. M. Guerrero, “DC microgrids—part i: A review of control strategies and stabilization techniques,” IEEE Transactions on Power Electronics, vol. 31, no. 7, pp. 4876–4891, Jul. 2016.
[2] M. Chinchilla, S. Arnaltes, and J. Burgos, “Control of permanent-magnet generators applied to variable-speed wind-energy systems connected to the grid,” IEEE Transactions on Energy Conversion, vol. 21, no. 1, pp. 130–135, 2006.
[3] K. Zhao et al., “Reliability evaluation of permanent magnet synchronous generators for offshore wind farms,” Wind Energy, vol. 24, no. 12, pp. 1447–1468, 2021.
[4] NASA, “POWER data access viewer,” https://power.larc.nasa.gov, 2024.
[5] C. Draxl, A. Hodge, A. Clifton, and B. Hodge, “The wind integration national dataset (WIND) toolkit,” National Renewable Energy Laboratory (NREL), Technical Report, 2015.
[6] DTU Wind Energy, “Global wind atlas datasets,” https://globalwindatlas. info, (https://globalwindatlas.info) 2021.
[7] H. Silva et al., “Design of a small wind turbine emulator for testing power converters using dSPACE 1104,” International Journal of Robotics and Control Systems, 2021.
[8] D. F. Bajonero-Sandoval, J. Sanabria-Vargas, and C. L. Trujillo-Rodríguez, “Design and implementation of a low power wind turbine emulator through the induction motor-permanent magnet generator arrangement,” Revista Facultad de Ingeniería, vol. 29, no. 54, p. e10530, 2020.
[9] M. Shokri et al., “Modeling of a PMSG-based wind turbine assisted by a three-phase diode rectifier and MPPT algorithm,” International Journal of Power and Energy Systems, vol. 41, no. 8, pp. 820–835, 2021.
[10] C. Sun et al., “A three-phase phase-modular single-ended primary-inductance converter (SEPIC) rectifier in discontinuous conduction mode (DCM) for small-scale wind turbine,” Energies, vol. 16, no. 13, p. 5220, 2023.
[11] M. Hung et al., “Three-phase single-stage AC-DC converter using series-series compensation in inductive-power-transfer-based small wind generation,” Applied Sciences, vol. 14, no. 17, p. 7769, 2024.
[12] IEC, “IEC 61400-21:2019 wind turbines – measurement and assessment of power quality characteristics of grid connected turbines,” International Standard, 2019.
[13] IEEE, “IEEE Std 1547-2018 standard for interconnection and interope-rability of distributed energy resources,” IEEE Standard, 2018.
[14] E. Espitia, “Base de datos experimental de par y curvas de potencia del generador síncrono AVAN-300W,” 2025, comunicacion personal, ´
Departamento de Ingeniería Electrica y Electr ´ | onica, Universidad de los ´
Andes.
[15] Rockwell Automation, PowerFlex 525 AC Drives User Manual, publica-tion 520-um001, rev. b ed., Rockwell Automation, 2020.

ANEXOS

Para garantizar la reproducibilidad científica del banco de
ensayos, el codigo fuente completo, los scripts de s ´ | íntesis
meteorologica y los firmwares de adquisici ´ | on se encuentran en ´
el repositorio de acceso abierto: https://github.com/JonathanDGonzalez/Wind-Turbine-Emulator-Gateway. (https://github.com/JonathanDGonzalez/Wind-Turbine-Emulator-Gateway) A continuacion, ´
se sintetiza la estructura logica de los m ´ | odulos principales. ´
A. Algoritmo de Conversion Viento-Frecuencia ´
El script ejecuta la síntesis estocastica del recurso de La Gua- ´ jira procesando las matrices climaticas ( ´ heatmapData.csv y windSpeed.csv) mediante la biblioteca numpy. El algoritmo aplica una interpolacion bilineal para derivar la ´ velocidad base estacional y acopla rafagas transitorias mediante ´ muestreo aleatorio por percentiles (ponderacion 70 % base, 30 % ´ turbulencia). Tras aplicar un filtro de media movil s ´ íncrono de 10 s para emular la inercia atmosferica real, el vector ´ continuo de velocidad se transforma en consignas de frecuencia estatorica filtradas entre 0 y 25.5 Hz mediante la curva por ´ tramos, exportandose directamente en el archivo secuencial de ´
ejecucion´ perfil_viento.csv.
B. Nucleo de Control Serial y Ciclo Activo Heartbeat ´
El control local del variador PowerFlex 525 opera mediante un hilo persistente (daemon thread) configurado para mitigar el temporizador de vigilancia (Watchdog) industrial y prevenir fallas por comunicacion ( ´ F081). Para evitar colisiones en el bus RS-485, el script encapsula la transmision utilizando ´
primitivas de exclusion mutua ( ´ | Mutex Locks). En cada iteracion, ´
el lazo bloquea de forma atomica el canal mediante el ´ objeto modbus_lock, ejecuta el escalamiento centesimal de la frecuencia (fescala = freal × 100) y despacha la trama Modbus RTU vía write_registers hacia las direcciones
físicas contiguas 8192 (control logico) y ´ | 8193 (referencia de
velocidad).
C. Abstraccion de Datos de la Pasarela SCADA TCP/IP ´ La interoperabilidad distribuida implementa una pasarela bidireccional concurrente mediante un servidor Modbus TCP (puerto 502) que traduce peticiones remotas en comandos
binarios de bajo nivel. El modulo opera de forma as ´ | íncrona en
dos etapas funcionales: 1) lee el estado del emulador e inyecta la telemetría electrica hacia los registros de lectura del SCADA; ´
y 2) evalua el testigo de jerarqu ´ | ía para autorizar comandos
booleanos externos, traduciendolos a codificaci ´ | on decimal de ´
hardware (18 para arranque en avance y 1 para parada por inercia). Un filtro de saturacion restringe la consigna forzada ´ entre 0 y 25.5 Hz antes de transferirla al hilo serial.
