JonathanDGonzalez/Wind-Turbine-Emulator-Gateway/docs/mathematical_model.pdf

PROYECTO: BREEZEWINGS

LISTADO DE VARIABLES Y PARÁMETROS FÍSICOS

Página
1 de 9

Elaboró: Edwin Espitia
13 abr 2026

CONTENIDO

LISTADO DE VARIABLES Y PARÁMETROS FÍSICOS 2 de 9

D. Nota: el escalamiento es NO LINEAL para Savonius porque cambia con el tamaño

LISTADO DE VARIABLES Y PARÁMETROS FÍSICOS 3 de 9

### 1. SISTEMA DE ECUACIONES

1.1. Tip Speed Ratio (TSR).

λ(t) =

ω(t)R
V(t)
1.2. Torque aerodinámico (Savonius).

Tt(t) =

1
2

ρAV(t)

2R ∙

Cp(λ(t))
λ(t)

[1 + kr sin(2θ(t))]

1.3. Dinámica mecánica.

dω(t)
dt =

1
J

[Tt

(t) − Tg

(t) − Bω(t)]

1.4. Cinemática rotacional. dθ(t)
dt = ω(t)
1.5. Modelo del variador (experimental).

Tg(t)=f(ω(t),fref(t))

1.6. Potencia eléctrica (medición).

Pout(t)=Vdc(t)⋅Idc(t)

1.7. Torque a partir de medición (alternativo).

Tg(t) =

Pout(t)
η ⋅ ω(t)

LISTADO DE VARIABLES Y PARÁMETROS FÍSICOS 4 de 9

1.8. Identificación de coeficiente de potencia.

Cp(λ) =

2Pout
ρAV³
A. Nota: las ecuaciones están en función de t (tiempo) porque: se está modelando un

sistema dinámico, no uno estático.

ω(t), θ (t),V(t), estas variables cambian en el tiempo.

La turbina NO está en equilibrio todo el tiempo. Porque el viento cambia, el variador

cambia su frecuencia, entonces, el sistema acelera o desacelera.

En conclusión:

dω(t)/dt ≠ 0

### 2. LISTADO DE VARIABLES Y PARÁMETROS

2.1. Variables dinámicas (estados).
Variable | Descripción | Unidad | Rango típico
ω(t) | Velocidad angular del rotor | rad/s | 5 – 80
θ(t) | Posición angular | rad | 0 – (2π)
λ(t) | Tip Speed Ratio | - | 0.3 – 1.2
2.2. Variables de entrada.
Variable | Descripción | Unidad | Rango
V(t) | Velocidad del viento | m/s | 2 – 12
fref(t) | Frecuencia del variador | Hz | 10 – 60

LISTADO DE VARIABLES Y PARÁMETROS FÍSICOS 5 de 9

2.3. Variables aerodinámicas.
Variable | Descripción | Unidad | Rango
Cp(λ) | Coeficiente de potencia | - | 0.1 – 0.3
Tt(t) | Torque aerodinámico | N·m | 0.05 – 0.5
2.4. Variables eléctricas (medidas).
Variable | Descripción | Unidad | Rango
Vdc(t) | Voltaje DC | V | 10 – 100
Idc(t) | Corriente DC | A | 0 – 10
Pout(t) | Potencia eléctrica | W | 1 – 20
2.5. Variables del modelo del variador.
Variable | Descripción | Unidad
Tg(t) | Torque resistivo equivalente | N·m
2.6. Parámetros físicos (definidos por el túnel) para la geometría de la turbina.
Parámetro | Descripción | Valor típico
A | Área barrida | 0.1 m²
R | Radio | 0.15 m
D | Diámetro | 0.3 m
H | Altura | 0.33 m
2.7. Aire.
Parámetro | Descripción | Valor
ρ | Densidad del aire | 1.2 kg/m³

LISTADO DE VARIABLES Y PARÁMETROS FÍSICOS 6 de 9

2.8. Mecánica.
Parámetro | Descripción | Valor
J | Inercia total | 0.005 kg·m²
B | Fricción viscosa | 0.001 N·m·s
2.9. Modelo Savonius.
Parámetro | Descripción | Valor
kr | Factor de ripple | 0.1 – 0.3
2.10. Sistema eléctrico.
Parámetro | Descripción | Valor
η | Eficiencia | 0.8 – 0.9

### 3. RELACIONES AUXILIARES

Evitar singularidad

λ > 0.1

Velocidad angular

ω=λV / R

Equilibrio en régimen permanente

Tt=Tg
INTERPRETACIÓN FÍSICA

Este modelo describe:

Viento→Torque aerodinámico→Dinámica del rotor→Carga (variador)

LISTADO DE VARIABLES Y PARÁMETROS FÍSICOS 7 de 9

### 4. CONEXIÓN DIRECTA CON TYPHOON

Cada ecuación se realciona así:

Ecuación | Bloque Typhoon
λ | Divide + Gain
Cp(λ) | Lookup Table 1D
Tt | Math blocks
Dinámica | Mechanical Inertia
Tg | Lookup Table 2D
θ | Integrator
B. Nota: según la geometría del túnel de viento de la universidad, se tienen los siguientes

valores teóricos para cada una de las variables de una turbina tipo Savonius.

5. RANGO DE MAGNITUDES MÁXIMAS TEÓRICAS (EJEMPLO).
- V = 8 m/s
- A = 0.1 m²
- Cp = 0.2
5.1. Potencia.

Pt = (1/2)(1.2)(0.1)(8

3
)(0.2)

Pt ≈ 6.14 W

5.2. Velocidad angular.

Con tip speed ratio (TSR) ≈ 0.8:

ω=λV/R

R = 0.15

ω ≈ 42.6 rad/s

5.3. Torque.

Tt = Pt/ω ≈ 0.14 N⋅m

C. Nota: el sistema es crítico porque opera en baja potencia.

LISTADO DE VARIABLES Y PARÁMETROS FÍSICOS 8 de 9

### 6. VALORES INICIALES RECOMENDADOS

6.1. Aerodinámico.
- Cp(λ): curva tipo Savonius.
- kr = 0.2
6.2. Mecánico.
- J = 0.005 , kg·m²
- B = 0.001
6.3. Generador.
- Rs=1Ω
- Ld=Lq=5 mH
- λm=0.1
- p=4
6.4. Carga.

R=20Ω

D. Nota: el escalamiento es NO LINEAL para Savonius porque cambia con el tamaño

Reynolds y Cp. Por eso se hace feedback con el túnel de viento.

E. Nota: el tamaño del prototipo está limitado para evitar flujo acelerado artificial en el

túnel de viento y por consiguiente potencia sobre calculada.

F. Nota: baja potencia = alta sensibilidad = afectan significativamente los resultados.

Entonces, atención especial a error en:

- Fricción.
- Alineación.
- Medición.

LISTADO DE VARIABLES Y PARÁMETROS FÍSICOS 9 de 9

### 7. VALIDACIÓN EN EMULACIÓN Y TÚNEL

Se mide:

- V
- ω
- Vdc
- Idc

Para reconstruir:

Cp(λ)
