JonathanDGonzalez/Wind-Turbine-Emulator-Gateway/wind_profile_emulator/perfil_viento_grafico.png

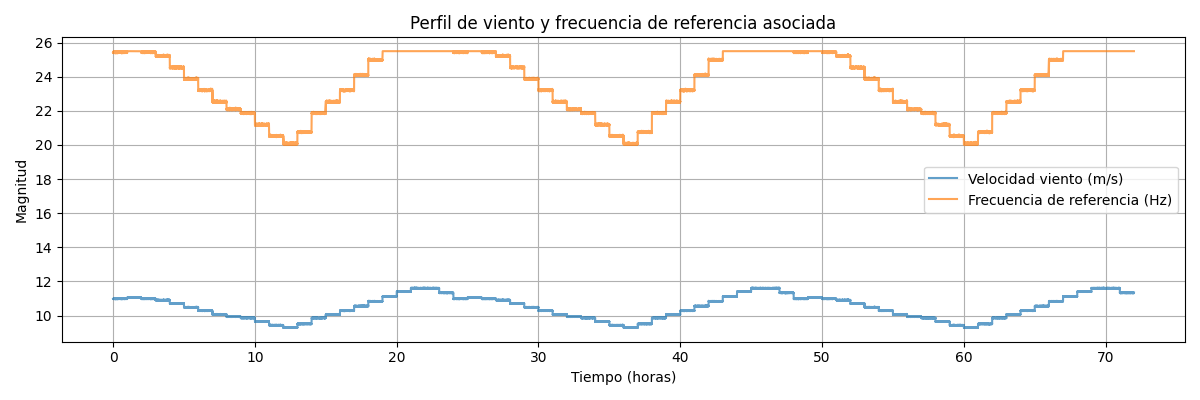
wind_profile_emulator/perfil_viento_grafico.png
