JonathanDGonzalez/Wind-Turbine-Emulator-Gateway/docs/schematic.pdf

VCC180V | Divisor de voltaje
OPAM | ISEN

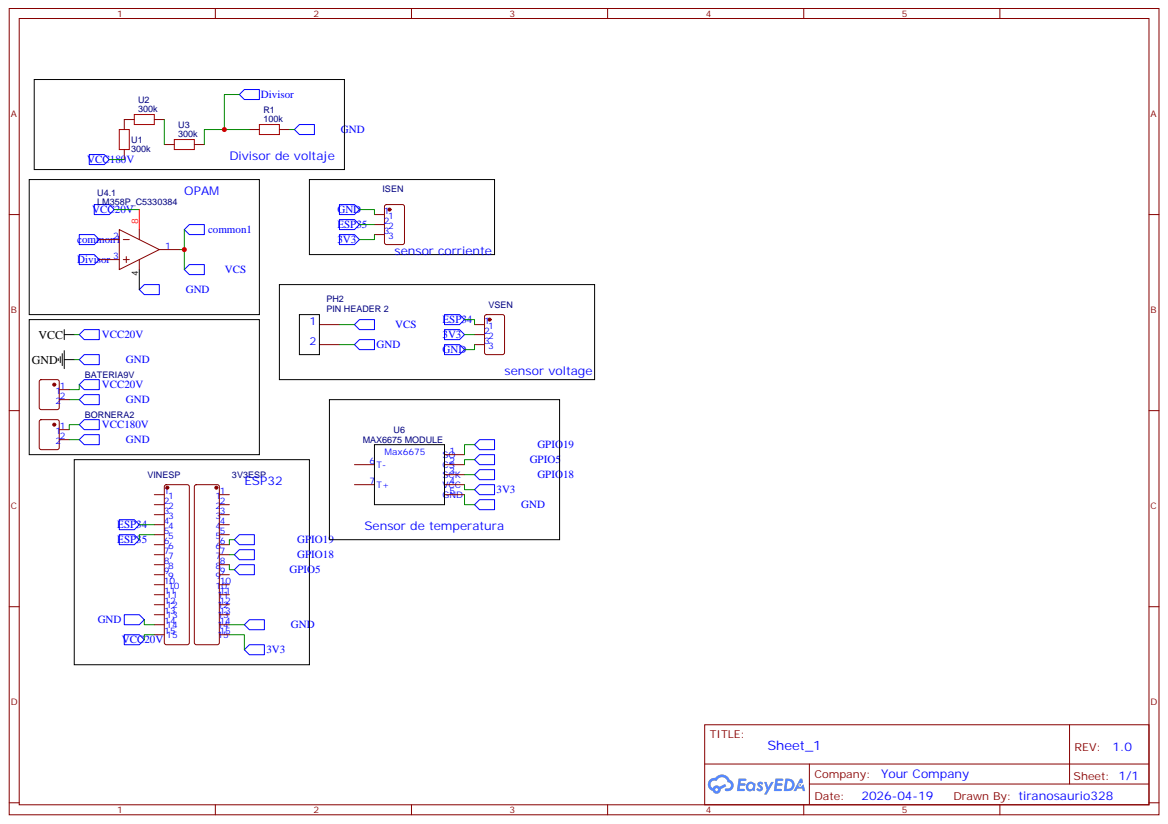
[picture p9: page 1]
